EzeMat21/Osciloscopio-STM32-utilizando-SerialPlot/TP1_Especial.pdf

20/07/2024

## TP1_Especial Project Configuration Report

# 1. Description

## 1.1. Project

Project Name | TP1_Especial
Board Name | custom
Generated with: | STM32CubeMX 6.12.0
Date | 07/20/2024

## 1.2. MCU

MCU Series | STM32F1
MCU Line | STM32F103
MCU name | STM32F103C8Tx
MCU Package | LQFP48
MCU Pin number | 48

## 1.3. Core(s) information

Core(s) | Arm Cortex-M3

# 2. Pinout Configuration

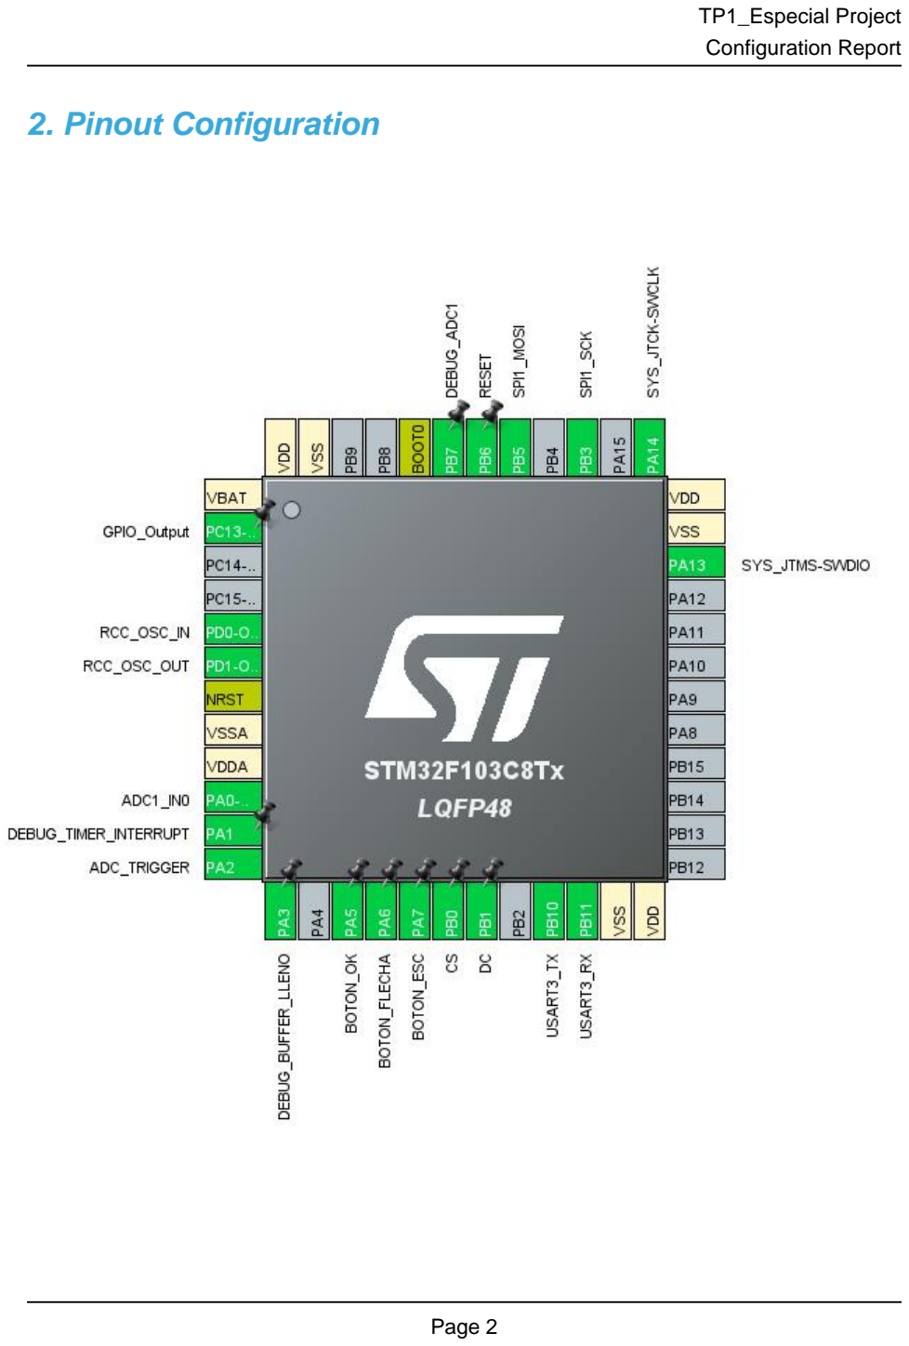
[picture p12: page 3]

# 3. Pins Configuration

Pin Number LQFP48 | Pin Name (function after reset) | Pin Type | Alternate Function(s) | Label
1 | VBAT | Power
2 | PC13-TAMPER-RTC * | I/O | GPIO_Output
5 | PD0-OSC_IN | I/O | RCC_OSC_IN
6 | PD1-OSC_OUT | I/O | RCC_OSC_OUT
7 | NRST | Reset
8 | VSSA | Power
9 | VDDA | Power
10 | PA0-WKUP | I/O | ADC1_IN0
11 | PA1 * | I/O | GPIO_Output | DEBUG_TIMER_INTERRU PT
12 | PA2 | I/O | ADC2_IN2 | ADC_TRIGGER
13 | PA3 * | I/O | GPIO_Output | DEBUG_BUFFER_LLENO
15 | PA5 | I/O | GPIO_EXTI5 | BOTON_OK
16 | PA6 | I/O | GPIO_EXTI6 | BOTON_FLECHA
17 | PA7 | I/O | GPIO_EXTI7 | BOTON_ESC
18 | PB0 * | I/O | GPIO_Output | CS
19 | PB1 * | I/O | GPIO_Output | DC
21 | PB10 | I/O | USART3_TX
22 | PB11 | I/O | USART3_RX
23 | VSS | Power
24 | VDD | Power
34 | PA13 | I/O | SYS_JTMS-SWDIO
35 | VSS | Power
36 | VDD | Power
37 | PA14 | I/O | SYS_JTCK-SWCLK
39 | PB3 | I/O | SPI1_SCK
41 | PB5 | I/O | SPI1_MOSI
42 | PB6 * | I/O | GPIO_Output | RESET
43 | PB7 * | I/O | GPIO_Output | DEBUG_ADC1
44 | BOOT0 | Boot
47 | VSS | Power
48 | VDD | Power

## * The pin is affected with an I/O function

# 4. Clock Tree Configuration

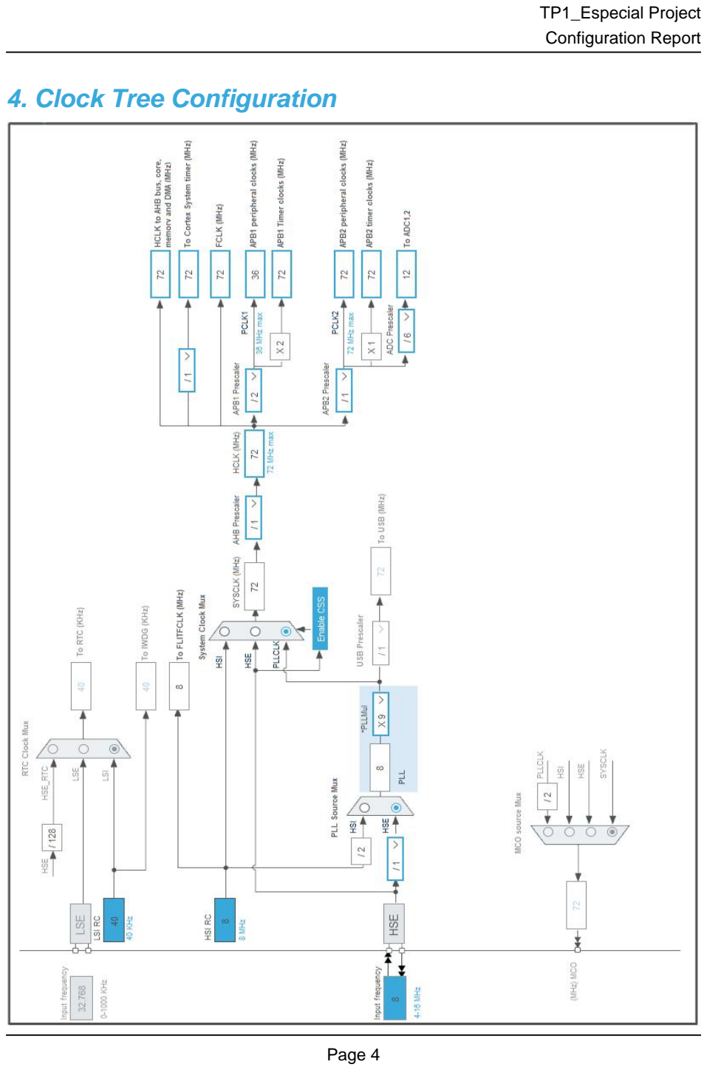
[picture p13: page 5]

# 1. Power Consumption Calculator report

## 1.1. Microcontroller Selection

Series | STM32F1
Line | STM32F103
MCU | STM32F103C8Tx
Datasheet | DS5319_Rev17

## 1.2. Parameter Selection

Temperature | 25
Vdd | 3.3

## 1.3. Battery Selection

Battery | Li-SOCL2(A3400)
Capacity | 3400.0 mAh
Self Discharge | 0.08 %/month
Nominal Voltage | 3.6 V
Max Cont Current | 100.0 mA
Max Pulse Current | 200.0 mA
Cells in series | 1
Cells in parallel | 1

## 1.4. Sequence

Step | Step1 | Step2
Mode | RUN | STOP
Vdd | 3.3 | 3.3
Voltage Source | Battery | Battery
Range | No Scale | No Scale
Fetch Type | FLASH | n/a
CPU Frequency | 72 MHz | 0 Hz
Clock Configuration | HSE PLL | Regulator_LP
Clock Source Frequency | 8 MHz | 0 Hz

### Peripherals

Additional Cons. | 0 mA | 0 mA
Average Current | 27 mA | 14 µA
Duration | 0.1 ms | 0.9 ms
DMIPS | 90.0 | 0.0
Ta Max | 100.1 | 105
Category | In DS Table | In DS Table

## 1.5. Results

Sequence Time | 1 ms | Average Current | 2.71 mA
Battery Life | 1 month, 21 days, 17 hours | Average DMIPS | 61.0 DMIPS

## 1.6. Chart


# 2. Software Project

## 2.1. Project Settings

Name | Value
Project Name | TP1_Especial
Project Folder | C:\Users\ezema\STM32CubeIDE\workspace_1.10.1\TP1_Especial
Toolchain / IDE | STM32CubeIDE
Firmware Package Name and Version | STM32Cube FW_F1 V1.8.5
Application Structure | Advanced
Generate Under Root | Yes
Do not generate the main() | No
Minimum Heap Size | 0x200
Minimum Stack Size | 0x400

## 2.2. Code Generation Settings

Name | Value
STM32Cube MCU packages and embedded software | Copy only the necessary library files
Generate peripheral initialization as a pair of '.c/.h' files | No
Backup previously generated files when re-generating | No
Keep User Code when re-generating | Yes
Delete previously generated files when not re-generated | Yes
Set all free pins as analog (to optimize the power consumption) | No
Enable Full Assert | No

## 2.3. Advanced Settings - Generated Function Calls

Rank | Function Name | Peripheral Instance Name
1 | SystemClock_Config | RCC
2 | MX_GPIO_Init | GPIO
3 | MX_ADC1_Init | ADC1
4 | MX_TIM2_Init | TIM2
5 | MX_USART3_UART_Init | USART3
6 | MX_ADC2_Init | ADC2
7 | MX_SPI1_Init | SPI1

# 3. Peripherals and Middlewares Configuration

## 3.1. ADC1 mode: IN0

## 3.1.1. Parameter Settings:

### ADCs_Common_Settings:

Mode | Independent mode

### ADC_Settings:

Data Alignment | Right alignment
Scan Conversion Mode | Disabled
Continuous Conversion Mode | Disabled
Discontinuous Conversion Mode | Disabled

### ADC_Regular_ConversionMode:

Enable Regular Conversions | Enable
Number Of Conversion | 1
External Trigger Conversion Source | Regular Conversion launched by software
Rank | 1
Channel | Channel 0
Sampling Time | 1.5 Cycles

### ADC_Injected_ConversionMode:

Enable Injected Conversions | Disable

### WatchDog:

Enable Analog WatchDog Mode | false

## 3.2. ADC2 mode: IN2

## 3.2.1. Parameter Settings:

### ADCs_Common_Settings:

Mode | Independent mode

### ADC_Settings:

Data Alignment | Right alignment
Scan Conversion Mode | Disabled
Continuous Conversion Mode | Disabled
Discontinuous Conversion Mode | Disabled

### ADC_Regular_ConversionMode:

Enable Regular Conversions | Enable
Number Of Conversion | 1

External Trigger Conversion Source | Regular Conversion launched by software
Rank | 1
Channel | Channel 2
Sampling Time | 1.5 Cycles

### ADC_Injected_ConversionMode:

Enable Injected Conversions | Disable

### WatchDog:

Enable Analog WatchDog Mode | false

## 3.3. RCC High Speed Clock (HSE): Crystal/Ceramic Resonator

## 3.3.1. Parameter Settings:

### System Parameters:

VDD voltage (V) | 3.3
Prefetch Buffer | Enabled
Flash Latency(WS) | 2 WS (3 CPU cycle)

### RCC Parameters:

HSI Calibration Value | 16
HSE Startup Timout Value (ms) | 100
LSE Startup Timout Value (ms) | 5000

## 3.4. SPI1 Mode: Half-Duplex Master

## 3.4.1. Parameter Settings:

### Basic Parameters:

Frame Format | Motorola
Data Size | 8 Bits
First Bit | MSB First

### Clock Parameters:

Prescaler (for Baud Rate) | 64 *
Baud Rate | 1.125 MBits/s *
Clock Polarity (CPOL) | Low
Clock Phase (CPHA) | 1 Edge

### Advanced Parameters:

CRC Calculation | Disabled

NSS Signal Type | Software

## 3.5. SYS Debug: Serial Wire Timebase Source: SysTick

## 3.6. TIM2 Clock Source : Internal Clock

## 3.6.1. Parameter Settings:

### Counter Settings:

Prescaler (PSC - 16 bits value) | 72-1 *
Counter Mode | Up
Counter Period (AutoReload Register - 16 bits value ) | 20-1 *
Internal Clock Division (CKD) | No Division
auto-reload preload | Disable

### Trigger Output (TRGO) Parameters:

Master/Slave Mode (MSM bit) | Disable (Trigger input effect not delayed)
Trigger Event Selection | Reset (UG bit from TIMx_EGR)

## 3.7. USART3 Mode: Asynchronous

## 3.7.1. Parameter Settings:

### Basic Parameters:

Baud Rate | 950000 *
Word Length | 9 Bits (including Parity) *
Parity | Even *
Stop Bits | 1

### Advanced Parameters:

Data Direction | Transmit Only *
Over Sampling | 16 Samples

### * User modified value

# 4. System Configuration

## 4.1. GPIO configuration

IP | Pin | Signal | GPIO mode | GPIO pull/up pull down | Max Speed | User Label
ADC1 | PA0-WKUP | ADC1_IN0 | Analog mode | n/a | n/a
ADC2 | PA2 | ADC2_IN2 | Analog mode | n/a | n/a | ADC_TRIGGER
RCC | PD0-OSC_IN | RCC_OSC_IN | n/a | n/a | n/a
| PD1-OSC_OUT | RCC_OSC_OUT | n/a | n/a | n/a
SPI1 | PB3 | SPI1_SCK | Alternate Function Push Pull | n/a | High *
| PB5 | SPI1_MOSI | Alternate Function Push Pull | n/a | High *
SYS | PA13 | SYS_JTMS-SWDIO | n/a | n/a | n/a
| PA14 | SYS_JTCK-SWCLK | n/a | n/a | n/a
USART3 | PB10 | USART3_TX | Alternate Function Push Pull | n/a | High *
| PB11 | USART3_RX | Input mode | No pull-up and no pull-down | n/a
GPIO | PC13-TAMPER-RTC | GPIO_Output | Output Push Pull | No pull-up and no pull-down | Low
| PA1 | GPIO_Output | Output Push Pull | No pull-up and no pull-down | Low | DEBUG_TIMER_INTERR UPT
| PA3 | GPIO_Output | Output Push Pull | No pull-up and no pull-down | Low | DEBUG_BUFFER_LLENO
| PA5 | GPIO_EXTI5 | External Interrupt Mode with Rising edge trigger detection | No pull-up and no pull-down | n/a | BOTON_OK
| PA6 | GPIO_EXTI6 | External Interrupt Mode with Rising edge trigger detection | No pull-up and no pull-down | n/a | BOTON_FLECHA
| PA7 | GPIO_EXTI7 | External Interrupt Mode with Rising edge trigger detection | No pull-up and no pull-down | n/a | BOTON_ESC
| PB0 | GPIO_Output | Output Push Pull | No pull-up and no pull-down | Low | CS
| PB1 | GPIO_Output | Output Push Pull | No pull-up and no pull-down | Low | DC
| PB6 | GPIO_Output | Output Push Pull | No pull-up and no pull-down | Low | RESET
| PB7 | GPIO_Output | Output Push Pull | No pull-up and no pull-down | Low | DEBUG_ADC1

## 4.2. DMA configuration

## nothing configured in DMA service

## 4.3. NVIC configuration

## 4.3.1. NVIC

Interrupt Table | Enable | Preenmption Priority | SubPriority
Non maskable interrupt | true | 0 | 0
Hard fault interrupt | true | 0 | 0
Memory management fault | true | 0 | 0
Prefetch fault, memory access fault | true | 0 | 0
Undefined instruction or illegal state | true | 0 | 0
System service call via SWI instruction | true | 0 | 0
Debug monitor | true | 0 | 0
Pendable request for system service | true | 0 | 0
System tick timer | true | 15 | 0
ADC1 and ADC2 global interrupts | true | 0 | 0
EXTI line[9:5] interrupts | true | 0 | 0
TIM2 global interrupt | true | 0 | 0
PVD interrupt through EXTI line 16 | unused
Flash global interrupt | unused
RCC global interrupt | unused
SPI1 global interrupt | unused
USART3 global interrupt | unused

## 4.3.2. NVIC Code generation

Enabled interrupt Table | Select for init sequence ordering | Generate IRQ handler | Call HAL handler
Non maskable interrupt | false | true | false
Hard fault interrupt | false | true | false
Memory management fault | false | true | false
Prefetch fault, memory access fault | false | true | false
Undefined instruction or illegal state | false | true | false
System service call via SWI instruction | false | true | false
Debug monitor | false | true | false
Pendable request for system service | false | true | false
System tick timer | false | true | true
ADC1 and ADC2 global interrupts | false | true | true
EXTI line[9:5] interrupts | false | true | true
TIM2 global interrupt | false | true | true

### * User modified value

# 5. System Views

## 5.1. Category view 5.1.1. Current

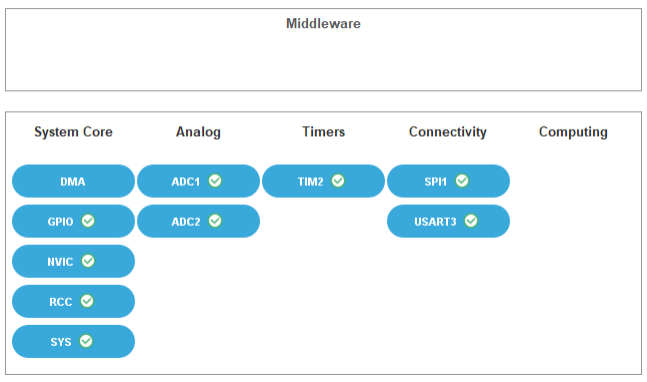
[picture p15: figure]

# 6. Docs & Resources

Type | Link
