EzeMat21/Osciloscopio-STM32-utilizando-SerialPlot/Core/Inc/main.h

#define DEBUG_TIMER_INTERRUPT_Pin GPIO_PIN_1
#define DEBUG_TIMER_INTERRUPT_GPIO_Port GPIOA
#define ADC_TRIGGER_Pin GPIO_PIN_2
#define ADC_TRIGGER_GPIO_Port GPIOA
#define DEBUG_BUFFER_LLENO_Pin GPIO_PIN_3
#define DEBUG_BUFFER_LLENO_GPIO_Port GPIOA
#define BOTON_OK_Pin GPIO_PIN_5
#define BOTON_OK_GPIO_Port GPIOA
#define BOTON_OK_EXTI_IRQn EXTI9_5_IRQn
#define BOTON_FLECHA_Pin GPIO_PIN_6
#define BOTON_FLECHA_GPIO_Port GPIOA
#define BOTON_FLECHA_EXTI_IRQn EXTI9_5_IRQn
#define BOTON_ESC_Pin GPIO_PIN_7
#define BOTON_ESC_GPIO_Port GPIOA
#define BOTON_ESC_EXTI_IRQn EXTI9_5_IRQn
#define CS_Pin GPIO_PIN_0
#define CS_GPIO_Port GPIOB
#define DC_Pin GPIO_PIN_1
#define DC_GPIO_Port GPIOB
#define RESET_Pin GPIO_PIN_6
#define RESET_GPIO_Port GPIOB
#define DEBUG_ADC1_Pin GPIO_PIN_7
#define DEBUG_ADC1_GPIO_Port GPIOB
