EzeMat21/Osciloscopio-STM32-utilizando-SerialPlot/(commit log)

2024-07-16 se agrego la pantalla tft y la transicion del estado stop al incio funciona
2024-07-21 se agrego para cambiar el periodo del timer en tiempo de ejecucion
